wrickert/RickNAS/CAD/CAD Documents/20x20-aluminium-profile-3.snapshot.1/2020 Aluminium profile/Profile dimensions.png

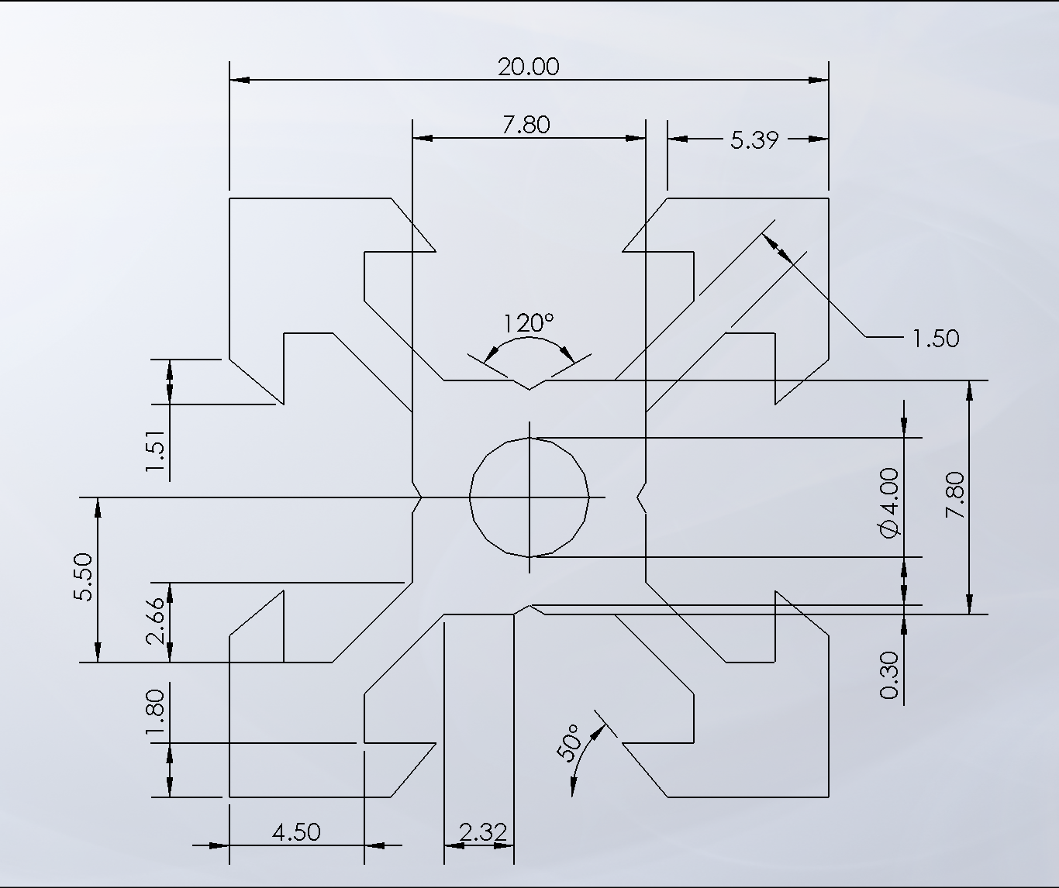
CAD/CAD Documents/20x20-aluminium-profile-3.snapshot.1/2020 Aluminium profile/Profile dimensions.png
