wrickert/RickNAS/CAD/CAD Documents/Front view.png

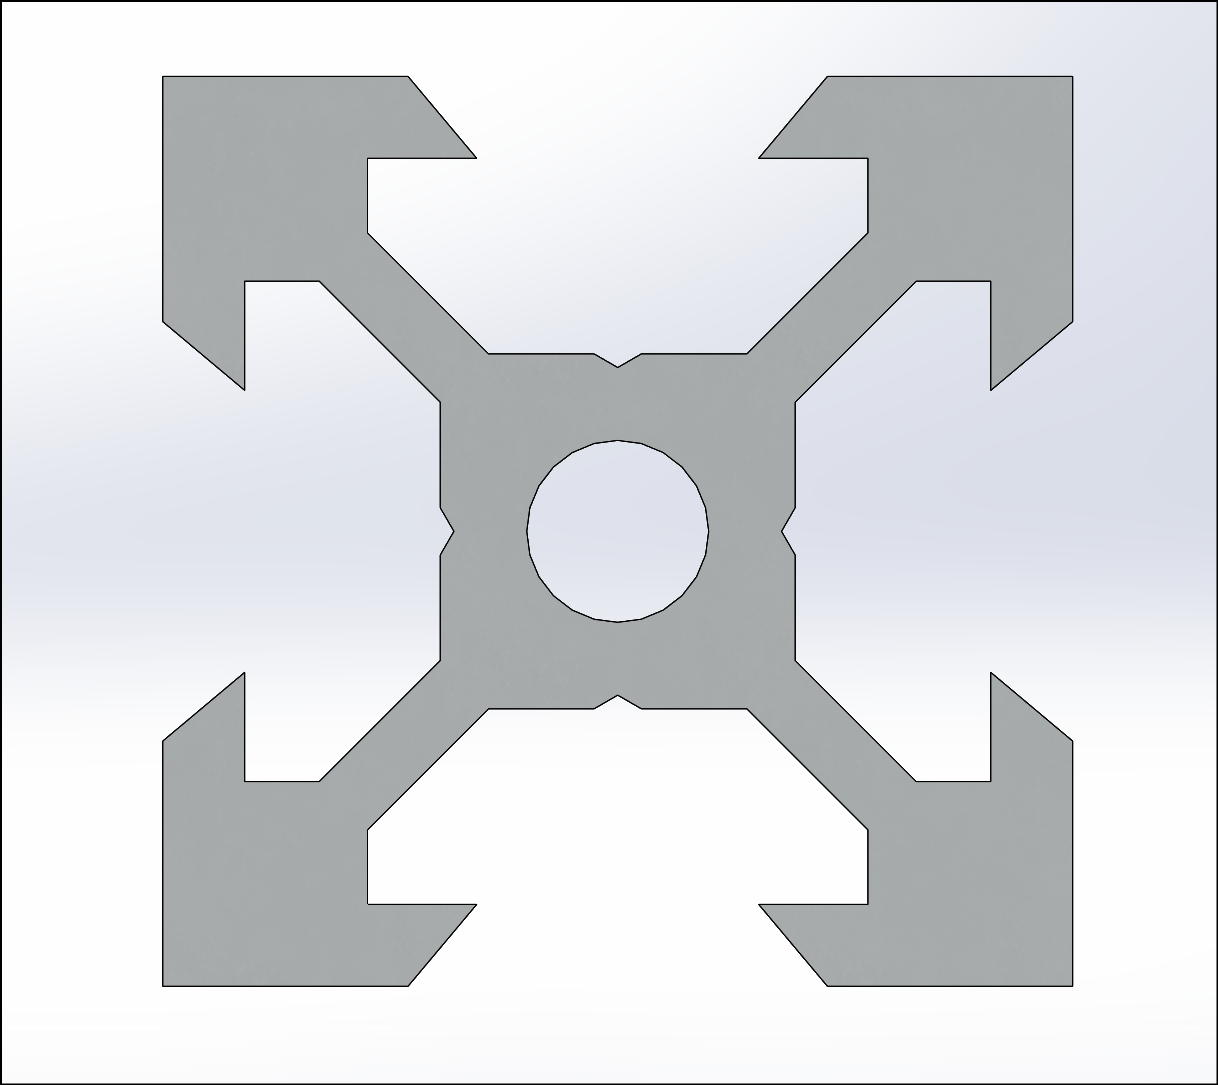
CAD/CAD Documents/Front view.png
