wrickert/RickNAS/Documents/H7c94ff64b4f14f66a1cd68da53533c7fg.jpg

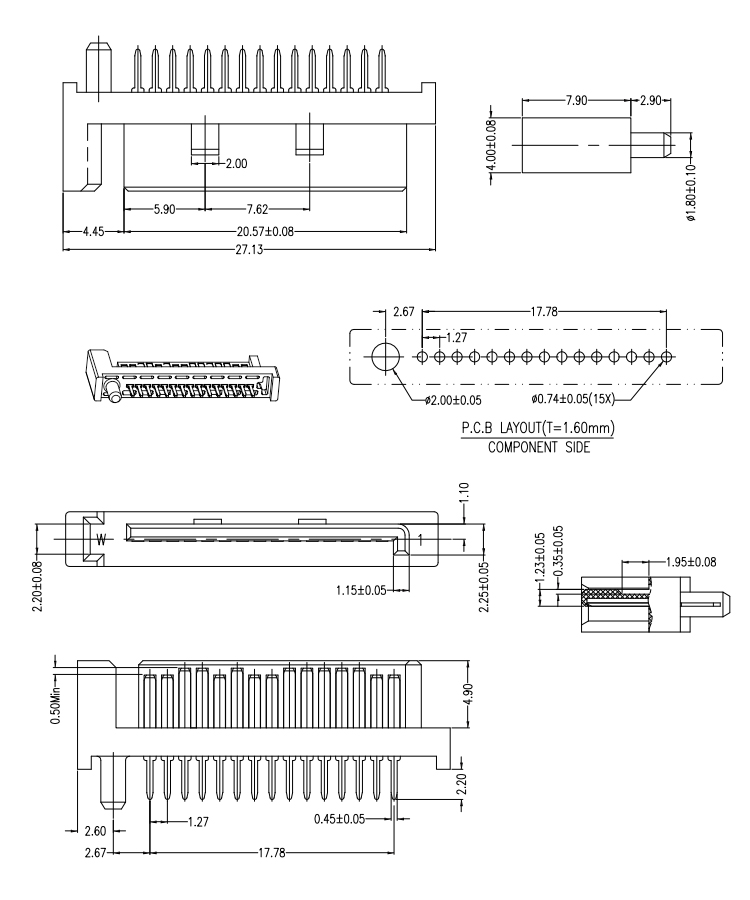
Documents/H7c94ff64b4f14f66a1cd68da53533c7fg.jpg
