wrickert/RickNAS/CAD/CAD Documents/20x20-aluminium-profile-3.snapshot.1/2020 Aluminium profile/ALUMINIUM_PROFILE_20m x 20mm x 500mm.SLDPRT

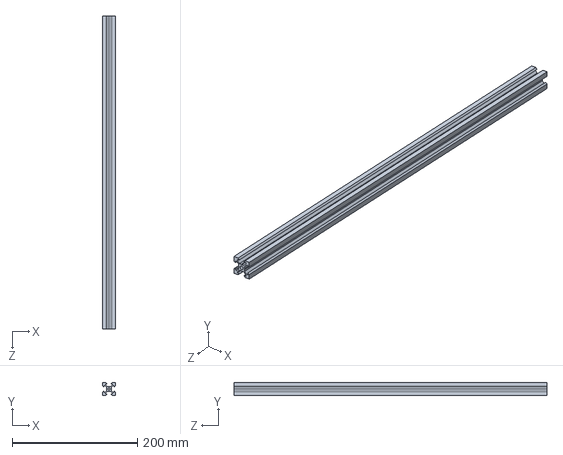
[picture p5: CAD file, 2026-01-15]
CAD/CAD Documents/20x20-aluminium-profile-3.snapshot.1/2020 Aluminium profile/ALUMINIUM_PROFILE_20m x 20mm x 500mm.SLDPRT
20.0 x 20.0 x 500.0 mm
