wrickert/RickNAS/CAD/RickNAS_Case.FCStd

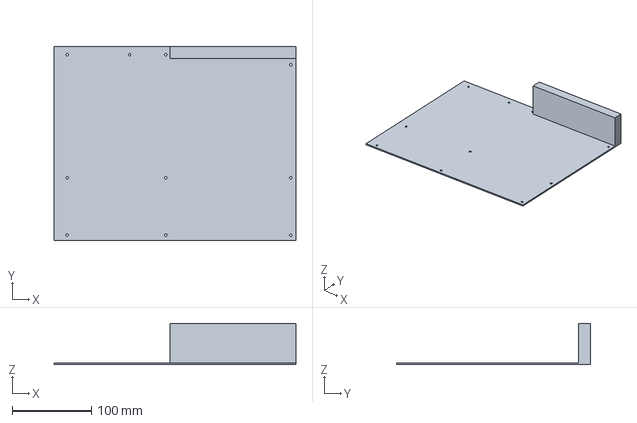
[picture p6: CAD file, 2026-01-15]
CAD/RickNAS_Case.FCStd
305.0 x 244.0 x 51.9 mm
