wrickert/RickNAS/Documents/2227595_1/2227595-1.step

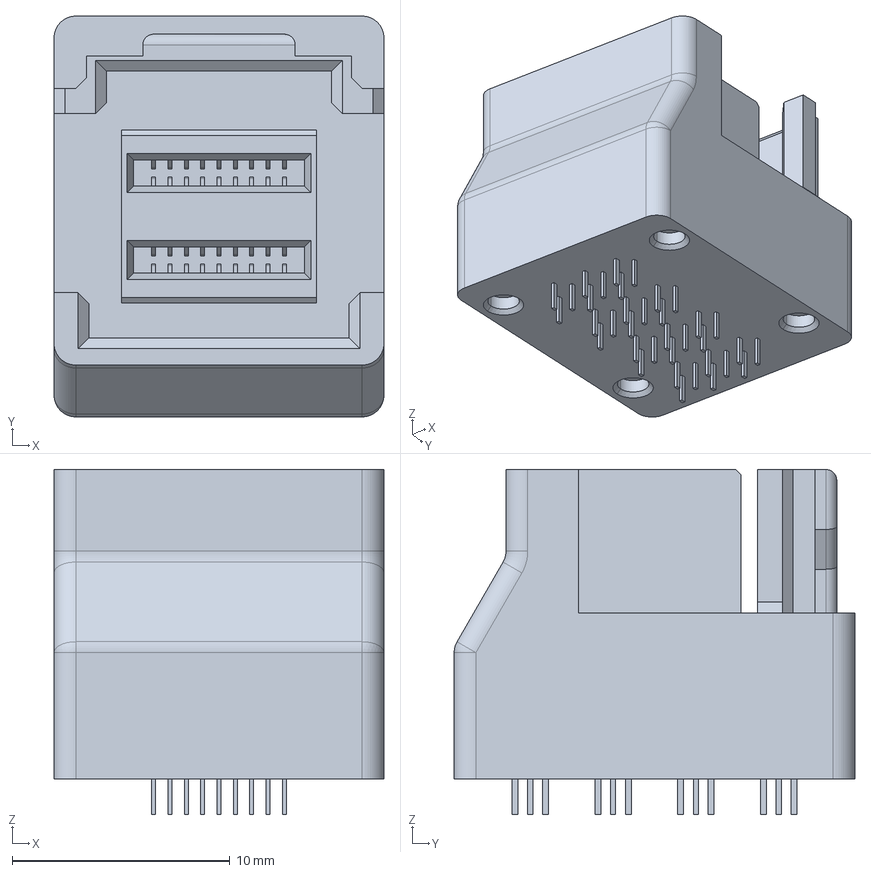
[picture p7: CAD file, 2026-01-15]
Documents/2227595_1/2227595-1.step
15.2 x 18.4 x 15.8 mm
