wrickert/RickNAS/(list of files, cad)

Other CAD files:
Documents/LIB_2227595-1/2227595-1/Allegro/22275951.psm
Documents/LIB_2227595-1/2227595-1/DEHDL/2227595_1/chips/chips.prt
