wrickert/RickNAS/Documents/PK-87839-001-001.pdf

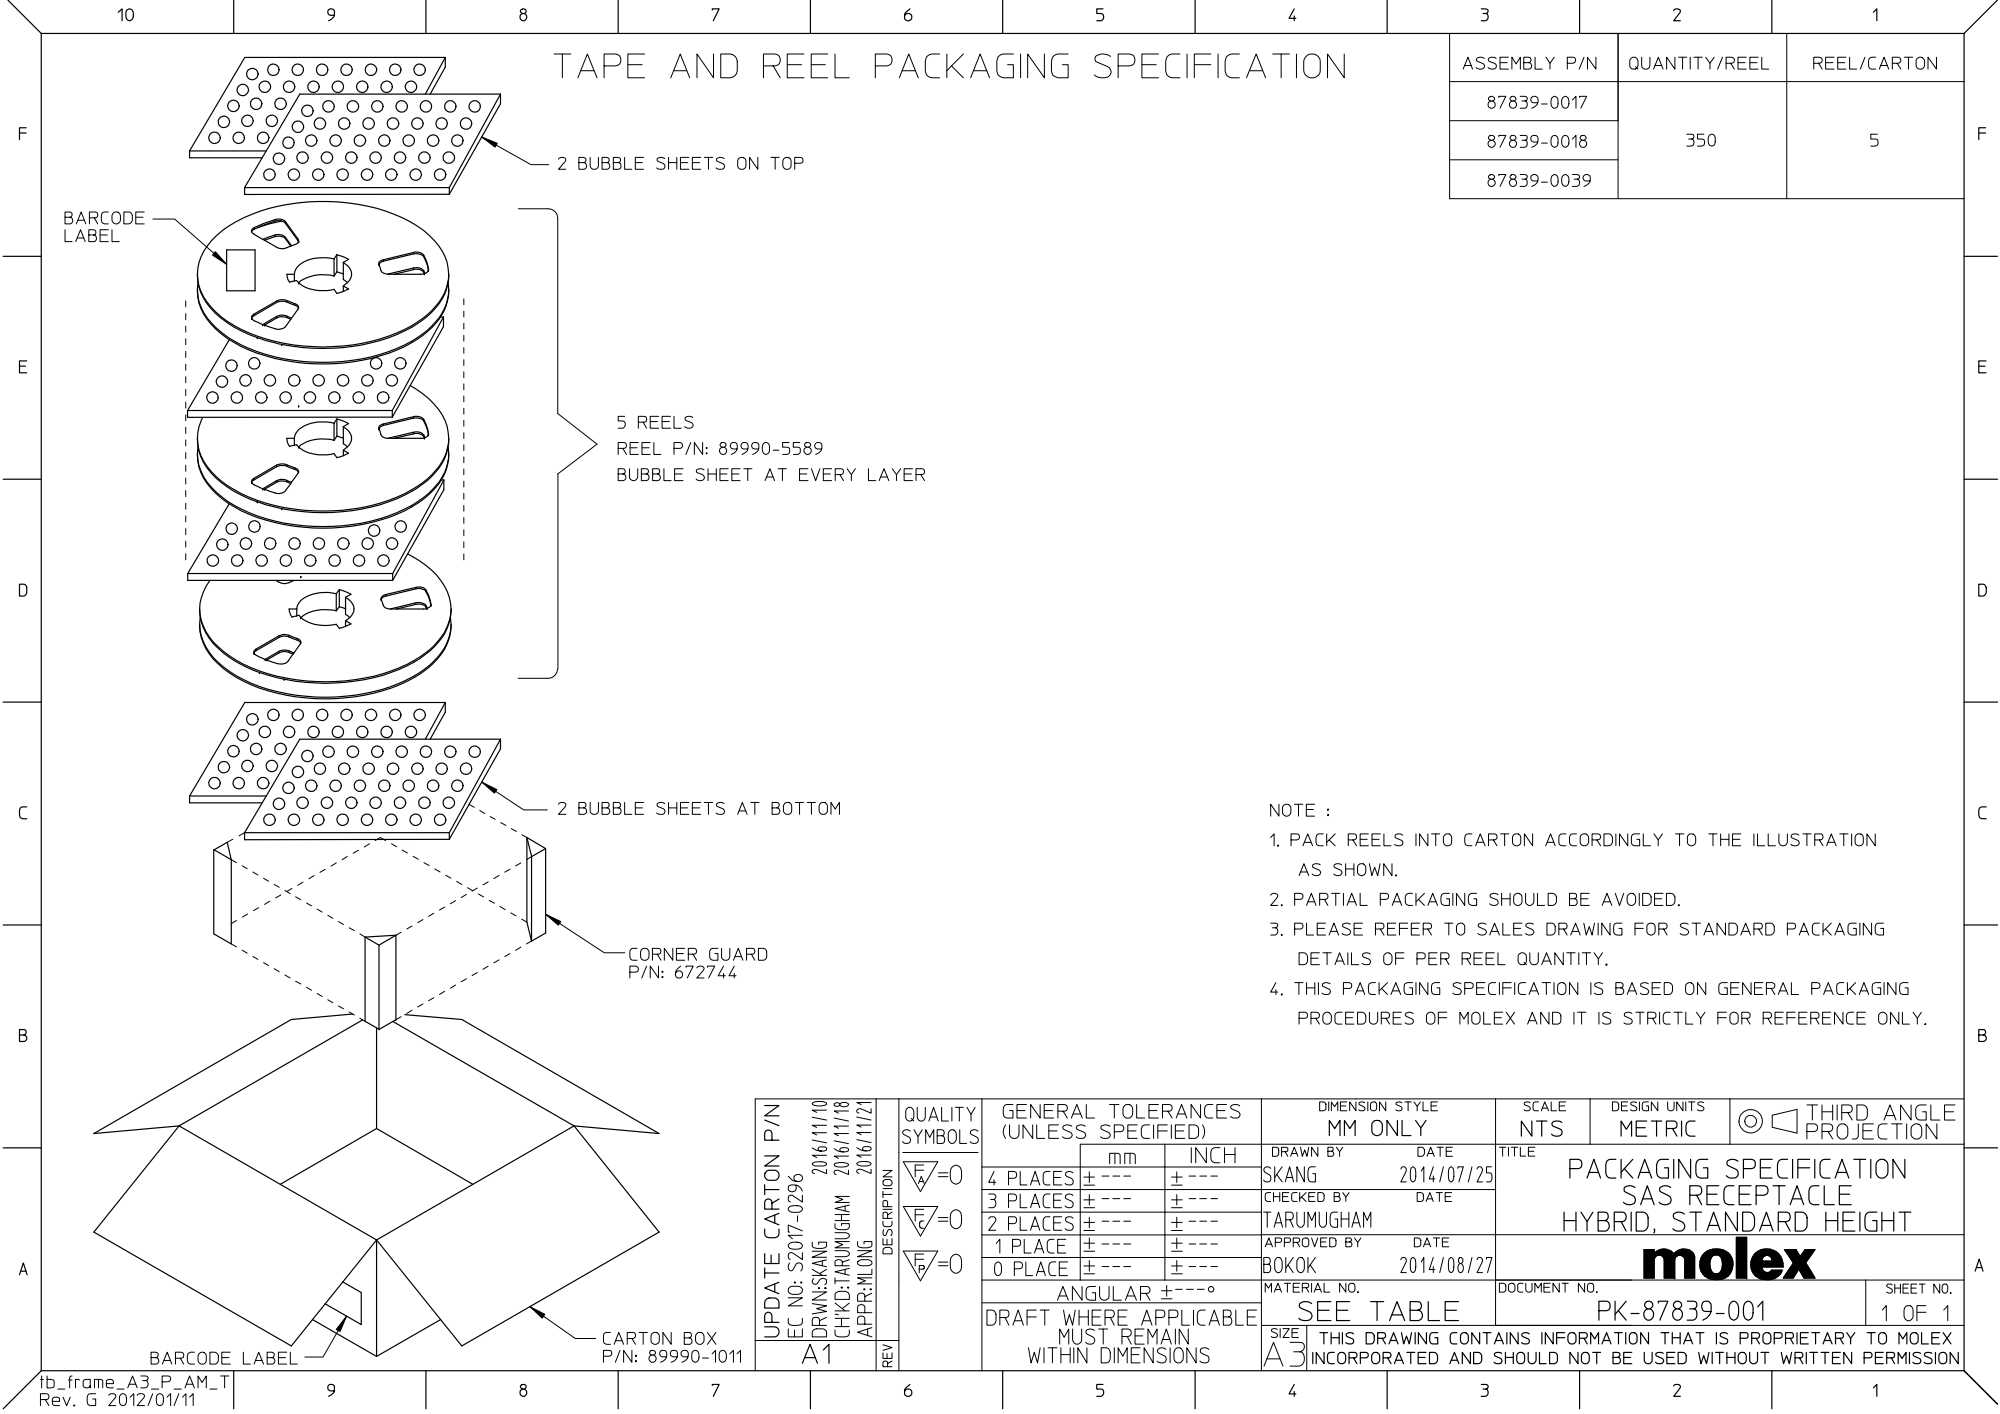
[picture p12: page 1]
