wrickert/RickNAS/(list of files, drawings)

Other design files:
Documents/LIB_2227595-1/2227595-1/Altium/2227595-1.SchLib
Documents/LIB_2227595-1/2227595-1/Altium/22275951.PcbLib
