wrickert/RickNAS/Schematics/V2 - 4 layer PCB/RickNAS_4PortSATA.kicad_pcb

## KiCad design Schematics/V2 - 4 layer PCB/RickNAS_4PortSATA.kicad_pcb (2026-09-16)

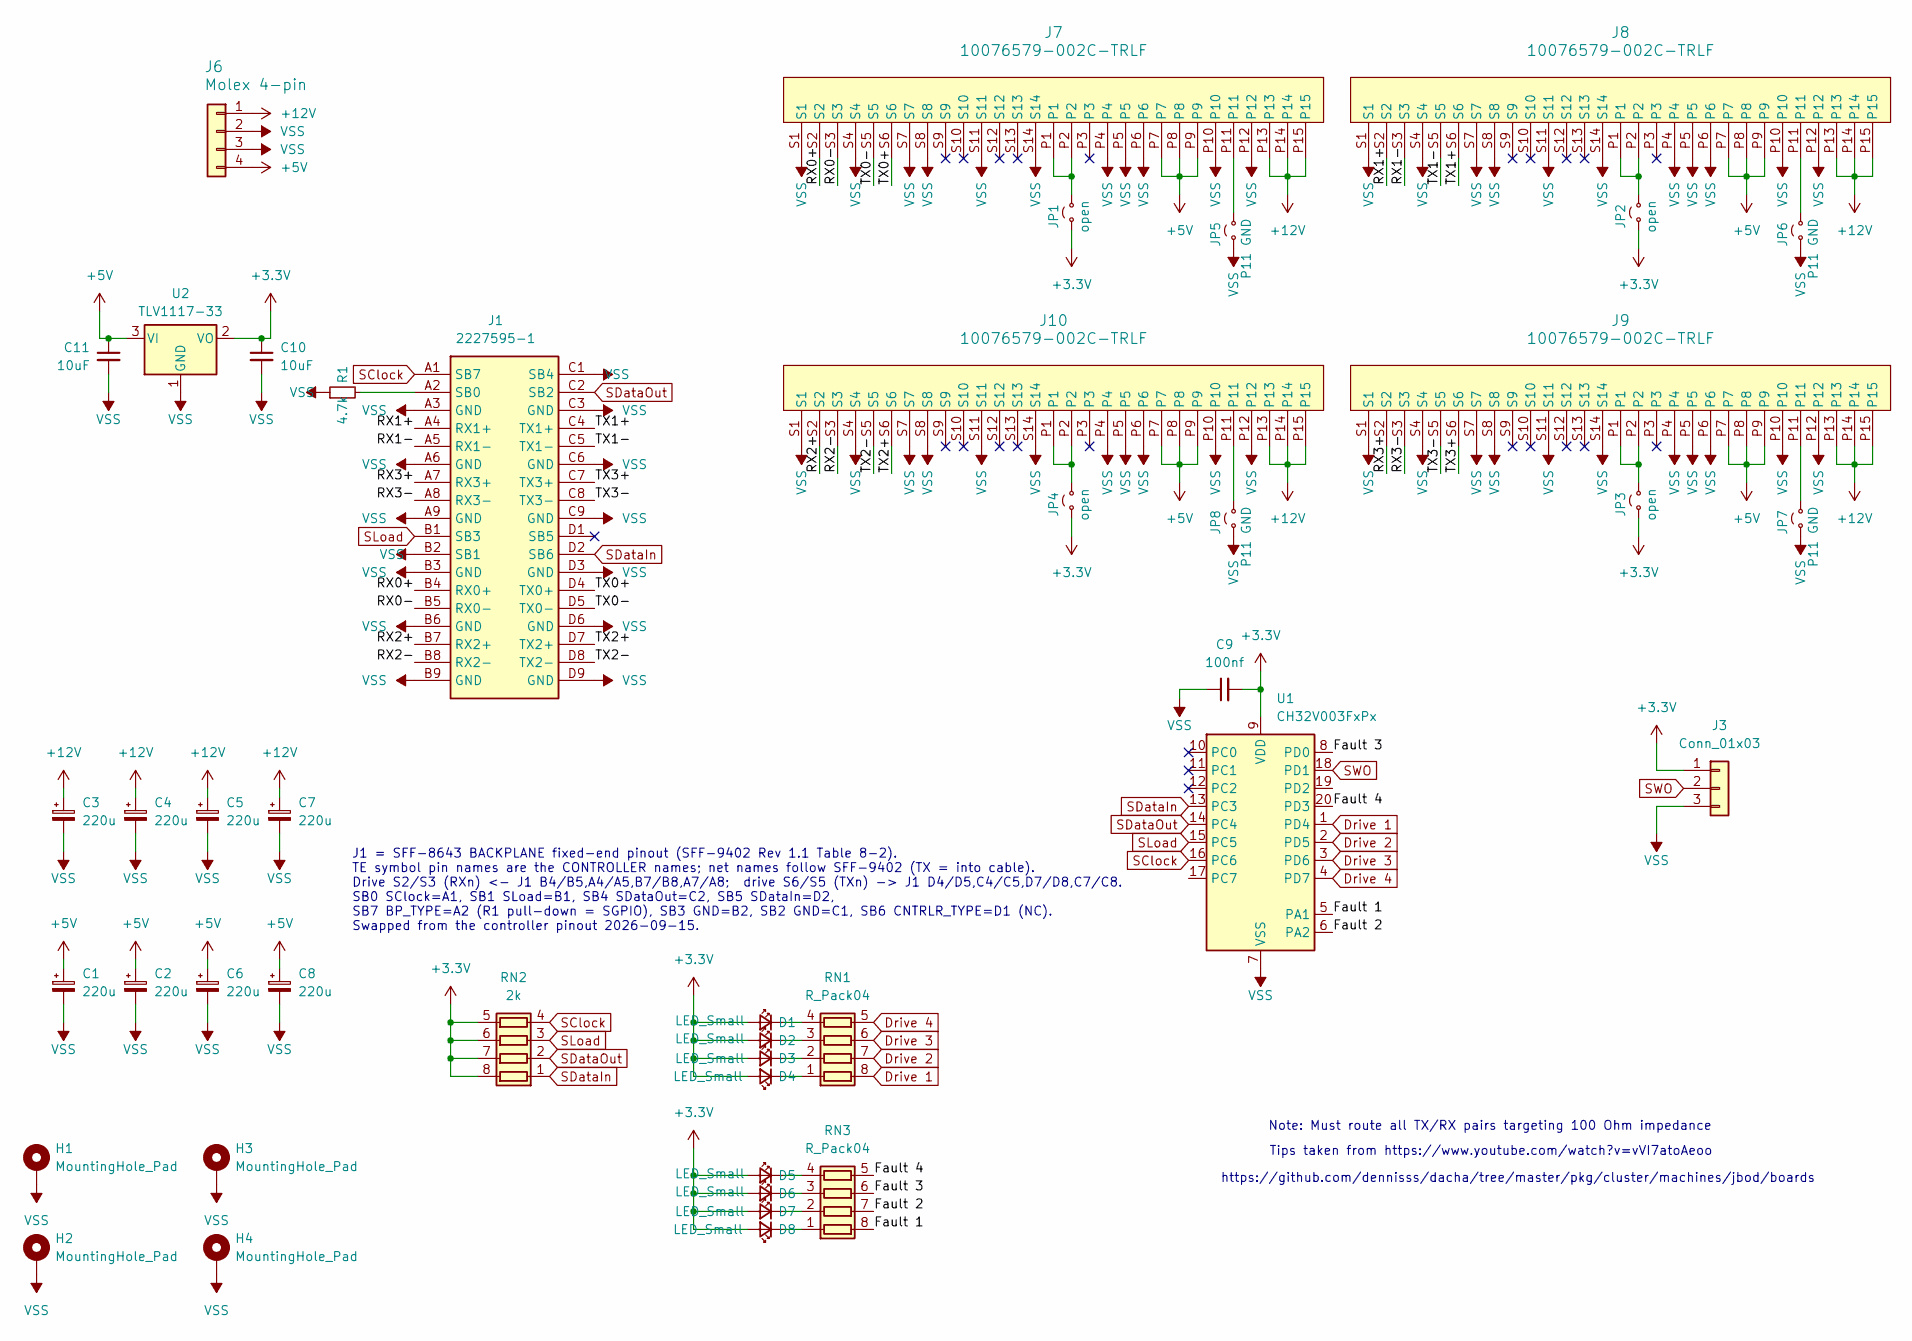
[picture p13: schematic RickNAS_4PortSATA.kicad_sch]

Parts:
C1, C2, C3, C4, C5, C6, C7, C8: 220u; CP_Radial_D10.0mm_P5.00mm
C9: 100nf; C_0805_2012Metric
C10, C11: 10uF; C_0805_2012Metric
D1, D2, D3, D4, D5, D6, D7, D8: LED_Small; LED_0805_2012Metric
H1, H2, H3, H4: MountingHole_Pad; MountingHole_3.2mm_M3_DIN965_Pad
J1: 2227595-1; 22275951; Manufacturer_Part_Number 2227595-1; Mouser Part Number 571-2227595-1
J3: Conn_01x03; PinHeader_1x03_P2.54mm_Vertical
J6: Molex 4-pin; TE_MATE-N-LOK_350211-1_1x04_P5.08mm_Vertical; MPN HC-C5080-4AS; LCSC C5221226
J7, J8, J9, J10: 10076579-002C-TRLF; 91908-291512_SAS_Conn
JP1, JP2, JP3, JP4: open; SolderJumper-2_P1.3mm_Open_TrianglePad1.0x1.5mm
JP5, JP6, JP7, JP8: P11 GND; SolderJumper-2_P1.3mm_Open_TrianglePad1.0x1.5mm
R1: 4.7k; R_0603_1608Metric
RN1, RN3: R_Pack04; R_Array_Concave_4x0603
RN2: 2k; R_Array_Concave_4x0603
U1: CH32V003FxPx; TSSOP-20_4.4x6.5mm_P0.65mm
U2: TLV1117-33; SOT-223-3_TabPin2

Connections:
+3.3V: C9.2, C10.1, D1.2 (A), D2.2 (A), D3.2 (A), D4.2 (A), D5.2 (A), D6.2 (A), D7.2 (A), D8.2 (A), J3.1, JP1.1 (A), JP2.1 (A), JP3.1 (A), JP4.1 (A), RN2.5 (R4.2), RN2.6 (R3.2), RN2.7 (R2.2), RN2.8 (R1.2), U1.9 (VDD), U2.2 (VO)
+5V: C1.1, C2.1, C6.1, C8.1, C11.1, J6.4, J7.P7, J7.P8, J7.P9, J8.P7, J8.P8, J8.P9, J9.P7, J9.P8, J9.P9, J10.P7, J10.P8, J10.P9, U2.3 (VI)
+12V: C3.1, C4.1, C5.1, C7.1, J6.1, J7.P13, J7.P14, J7.P15, J8.P13, J8.P14, J8.P15, J9.P13, J9.P14, J9.P15, J10.P13, J10.P14, J10.P15
/Fault 1: RN3.8 (R1.2), U1.5 (PA1)
/Fault 2: RN3.7 (R2.2), U1.6 (PA2)
/Fault 3: RN3.6 (R3.2), U1.8 (PD0)
/Fault 4: RN3.5 (R4.2), U1.20 (PD3)
/RX0+: J1.B4 (RX0+), J7.S2
/RX0-: J1.B5 (RX0-), J7.S3
/RX1+: J1.A4 (RX1+), J8.S2
/RX1-: J1.A5 (RX1-), J8.S3
/RX2+: J1.B7 (RX2+), J10.S2
/RX2-: J1.B8 (RX2-), J10.S3
/RX3+: J1.A7 (RX3+), J9.S2
/RX3-: J1.A8 (RX3-), J9.S3
/TX0+: J1.D4 (TX0+), J7.S6
/TX0-: J1.D5 (TX0-), J7.S5
/TX1+: J1.C4 (TX1+), J8.S6
/TX1-: J1.C5 (TX1-), J8.S5
/TX2+: J1.D7 (TX2+), J10.S6
/TX2-: J1.D8 (TX2-), J10.S5
/TX3+: J1.C7 (TX3+), J9.S6
/TX3-: J1.C8 (TX3-), J9.S5
Drive 1: RN1.8 (R1.2), U1.1 (PD4)
Drive 2: RN1.7 (R2.2), U1.2 (PD5)
Drive 3: RN1.6 (R3.2), U1.3 (PD6)
Drive 4: RN1.5 (R4.2), U1.4 (PD7)
unnamed: D1.1 (K), RN1.4 (R4.1)
unnamed: D2.1 (K), RN1.3 (R3.1)
unnamed: D3.1 (K), RN1.2 (R2.1)
unnamed: D4.1 (K), RN1.1 (R1.1)
unnamed: D5.1 (K), RN3.4 (R4.1)
unnamed: D6.1 (K), RN3.3 (R3.1)
unnamed: D7.1 (K), RN3.2 (R2.1)
unnamed: D8.1 (K), RN3.1 (R1.1)
unnamed: J1.A2 (SB0), R1.2
unnamed: J7.P1, J7.P2, JP1.2 (B)
unnamed: J8.P1, J8.P2, JP2.2 (B)
unnamed: J9.P1, J9.P2, JP3.2 (B)
unnamed: J10.P1, J10.P2, JP4.2 (B)
unnamed: J7.P11, JP5.2 (B)
unnamed: J8.P11, JP6.2 (B)
unnamed: J9.P11, JP7.2 (B)
unnamed: J10.P11, JP8.2 (B)
SClock: J1.A1 (SB7), RN2.4 (R4.1), U1.16 (PC6)
SDataIn: J1.D2 (SB6), RN2.1 (R1.1), U1.13 (PC3)
SDataOut: J1.C2 (SB2), RN2.2 (R2.1), U1.14 (PC4)
SLoad: J1.B1 (SB3), RN2.3 (R3.1), U1.15 (PC5)
SWO: J3.2, U1.18 (PD1)
VSS: C1.2, C2.2, C3.2, C4.2, C5.2, C6.2, C7.2, C8.2, C9.1, C10.2, C11.2, H1.1 (1_1), H2.1 (1_1), H3.1 (1_1), H4.1 (1_1), J1.A3 (GND), J1.A6 (GND), J1.A9 (GND), J1.B2 (SB1), J1.B3 (GND), J1.B6 (GND), J1.B9 (GND), J1.C1 (SB4), J1.C3 (GND), J1.C6 (GND), J1.C9 (GND), J1.D3 (GND), J1.D6 (GND), J1.D9 (GND), J3.3, J6.2, J6.3, J7.P4, J7.P5, J7.P6, J7.P10, J7.P12, J7.S1, J7.S4, J7.S7, J7.S8, J7.S11, J7.S14, J8.P4, J8.P5, J8.P6, J8.P10, J8.P12, J8.S1, J8.S4, J8.S7, J8.S8, J8.S11, J8.S14, J9.P4, J9.P5, J9.P6, J9.P10, J9.P12, J9.S1, J9.S4, J9.S7, J9.S8, J9.S11, J9.S14, J10.P4, J10.P5, J10.P6, J10.P10, J10.P12, J10.S1, J10.S4, J10.S7, J10.S8, J10.S11, J10.S14, JP5.1 (A), JP6.1 (A), JP7.1 (A), JP8.1 (A), R1.1, U1.7 (VSS), U2.1 (GND)

Notes on the sheet:
https://github.com/dennisss/dacha/tree/master/pkg/cluster/machines/jbod/boards
Tips taken from https://www.youtube.com/watch?v=vVI7atoAeoo
Note: Must route all TX/RX pairs targeting 100 Ohm impedance
J1 = SFF-8643 BACKPLANE fixed-end pinout (SFF-9402 Rev 1.1 Table 8-2). TE symbol pin names are the CONTROLLER names; net names follow SFF-9402 (TX = into cable). Drive S2/S3 (RXn) <- J1 B4/B5,A4/A5,B7/B8,A7/A8; drive S6/S5 (TXn) -> J1 D4/D5,C4/C5,D7/D8,C7/C8. SB0 SClock=A1, SB1 SLoad=B1, SB4 SDataO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

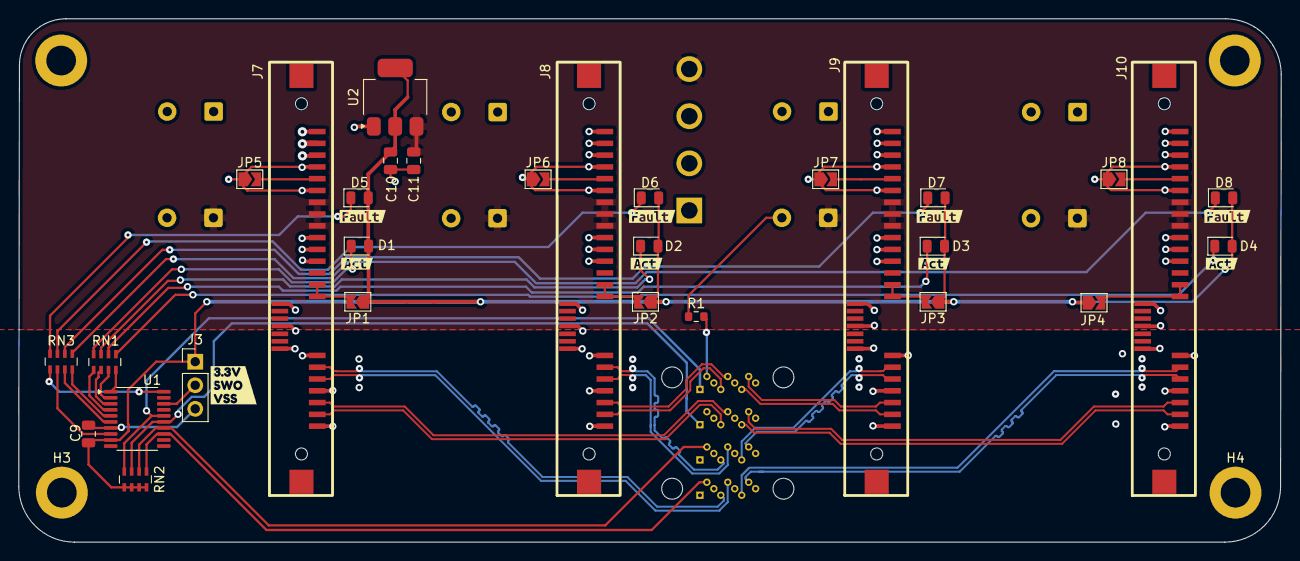
[picture p14: board Schematics/V2 - 4 layer PCB/RickNAS_4PortSATA.kicad_pcb from above]

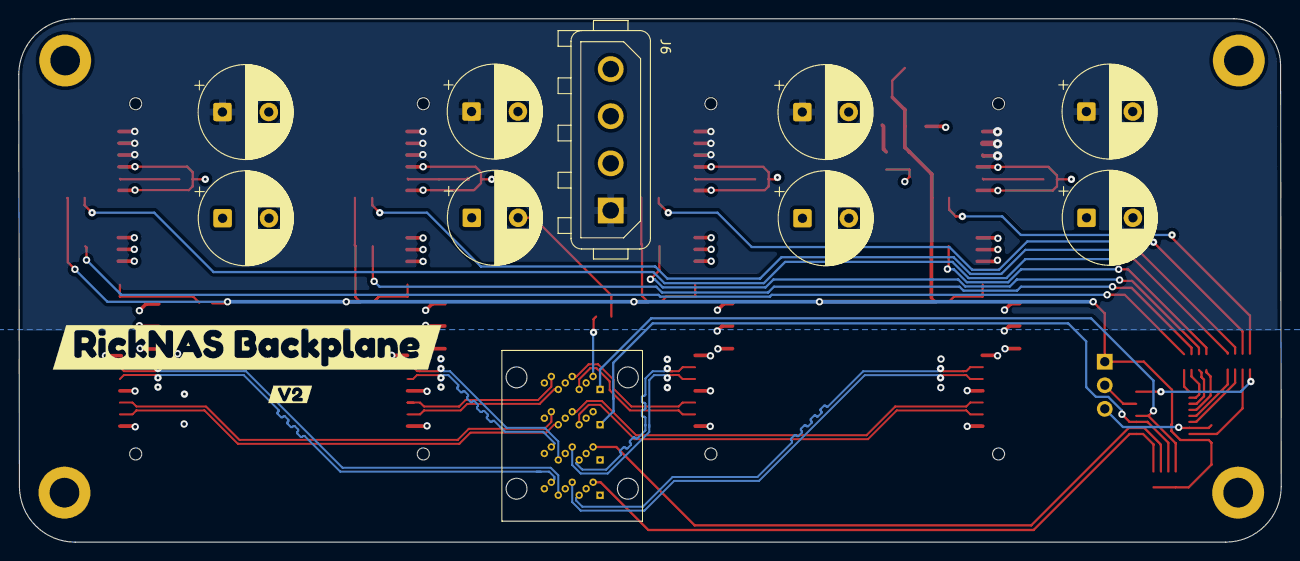
[picture p15: board Schematics/V2 - 4 layer PCB/RickNAS_4PortSATA.kicad_pcb from below]

Board: 4 copper layers, 136.1 x 56.4 mm, 55 parts (12 on the bottom side), 50 nets.

Other parts of the board:
kibuzzard-6AAAB40B: G***; kibuzzard-6AAAB40B
kibuzzard-6AAAB169, kibuzzard-6AAAB169#2, kibuzzard-6AAAB169#3, kibuzzard-6AAAB169#4: G***; kibuzzard-6AAAB169
kibuzzard-6AAAB175, kibuzzard-6AAAB175#2, kibuzzard-6AAAB175#3, kibuzzard-6AAAB175#4: G***; kibuzzard-6AAAB175
kibuzzard-6AAAC547: G***; kibuzzard-6AAAC547
kibuzzard-69861090: G***; kibuzzard-69861090
