wrickert/RickNAS/Schematics/V1 - 2 layer PCB/RickNAS_4PortSATA.kicad_pcb

## KiCad design Schematics/V1 - 2 layer PCB/RickNAS_4PortSATA.kicad_pcb (2025-03-04)

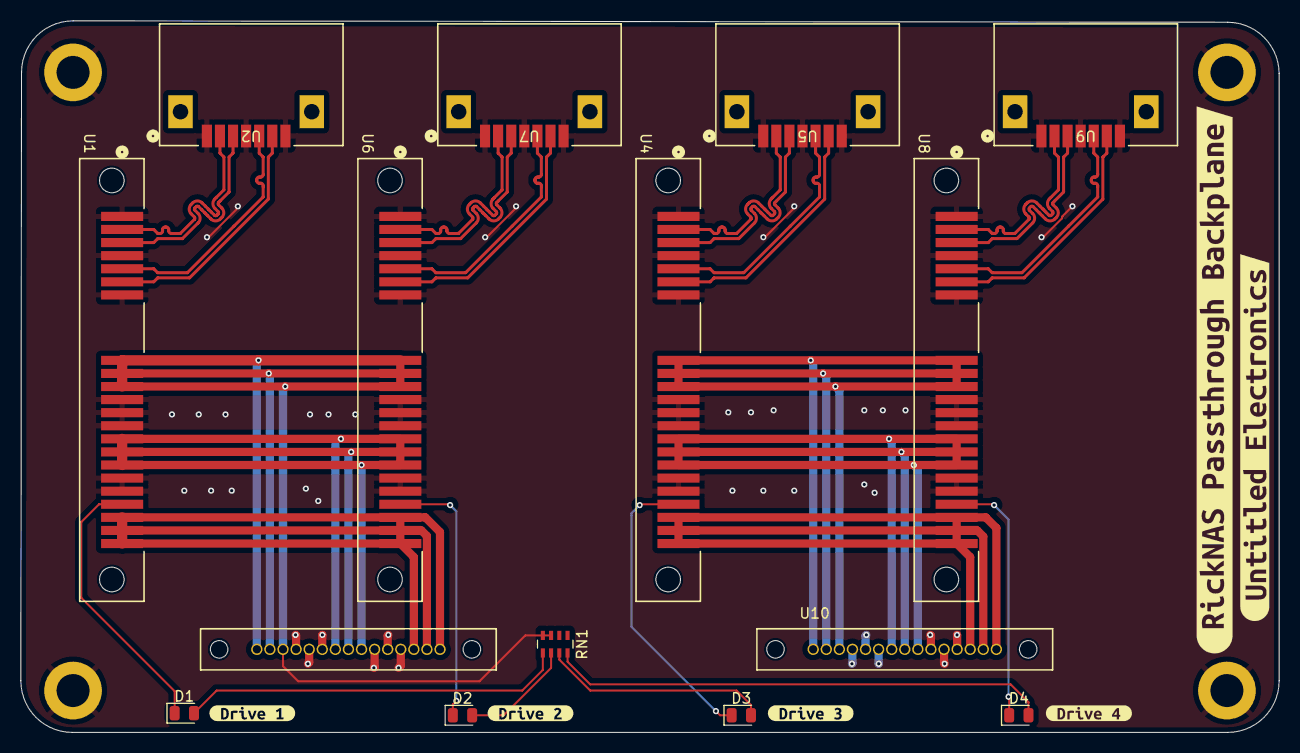
[picture p16: board Schematics/V1 - 2 layer PCB/RickNAS_4PortSATA.kicad_pcb from above]

Board: 2 copper layers, 122.1 x 69.1 mm, 25 parts (0 on the bottom side), 31 nets.

Parts:
D1, D2, D3, D4: LED_Small; LED_0805_2012Metric
H1, H2, H3, H4: MountingHole_Pad; MountingHole_3.2mm_M3_DIN965_Pad
RN1: R_Pack04; R_Array_Concave_4x0603
U1, U4, U6, U8: SATA_Combined; CONN22_877811_MOL
U2, U5, U7, U9: SATA_Data; CONN_67490-1220_MOL
U3, U10: SATA_Power; alim_SATA
kibuzzard-67B4AC4E: G***; kibuzzard-67B4AC4E
kibuzzard-67B605A5: G***; kibuzzard-67B605A5
kibuzzard-67B605B2: G***; kibuzzard-67B605B2
kibuzzard-67B6042A: G***; kibuzzard-67B6042A
kibuzzard-67B60589: G***; kibuzzard-67B60589
kibuzzard-67B60597: G***; kibuzzard-67B60597

Connections:
+3.3V: RN1.1 (R1.1), RN1.2 (R2.1), RN1.3 (R3.1), RN1.4 (R4.1), U1.8 (3.3V), U1.9 (3.3V), U1.10 (3.3V), U3.1 (3.3V), U3.2 (3.3V), U3.3 (3.3V), U6.8 (3.3V), U6.9 (3.3V), U6.10 (3.3V)
+3.3VP: U4.8 (3.3V), U4.9 (3.3V), U4.10 (3.3V), U8.8 (3.3V), U8.9 (3.3V), U8.10 (3.3V), U10.1 (3.3V), U10.2 (3.3V), U10.3 (3.3V)
+5P: U4.14 (5V), U4.15 (5V), U4.16 (5V), U8.14 (5V), U8.15 (5V), U8.16 (5V), U10.7 (5V), U10.8 (5V), U10.9 (5V)
+5V: U1.14 (5V), U1.15 (5V), U1.16 (5V), U3.7 (5V), U3.8 (5V), U3.9 (5V), U6.14 (5V), U6.15 (5V), U6.16 (5V)
+12P: U4.20 (12V), U4.21 (12V), U4.22 (12V), U8.20 (12V), U8.21 (12V), U8.22 (12V), U10.13 (12V), U10.14 (12V), U10.15 (12V)
+12V: U1.20 (12V), U1.21 (12V), U1.22 (12V), U3.13 (12V), U3.14 (12V), U3.15 (12V), U6.20 (12V), U6.21 (12V), U6.22 (12V)
/A1+: U4.2 (A+), U5.2 (A+)
/A1-: U4.3 (A-), U5.3 (A-)
/A2+: U6.2 (A+), U7.2 (A+)
/A2-: U6.3 (A-), U7.3 (A-)
/A3+: U8.2 (A+), U9.2 (A+)
/A3-: U8.3 (A-), U9.3 (A-)
/A+: U1.2 (A+), U2.2 (A+)
/A-: U1.3 (A-), U2.3 (A-)
/B1+: U4.6 (B+), U5.6 (B+)
/B1-: U4.5 (B-), U5.5 (B-)
/B2+: U6.6 (B+), U7.6 (B+)
/B2-: U6.5 (B-), U7.5 (B-)
/B3+: U8.6 (B+), U9.6 (B+)
/B3-: U8.5 (B-), U9.5 (B-)
/B+: U1.6 (B+), U2.6 (B+)
/B-: U1.5 (B-), U2.5 (B-)
Drive 1: D1.1 (K), U1.19 (VSS)
Drive 2: D2.1 (K), U6.19 (VSS)
Drive 3: D3.1 (K), U4.19 (VSS)
Drive 4: D4.1 (K), U8.19 (VSS)
unnamed: D1.2 (A), RN1.5 (R4.2)
unnamed: D2.2 (A), RN1.6 (R3.2)
unnamed: D3.2 (A), RN1.7 (R2.2)
unnamed: D4.2 (A), RN1.8 (R1.2)
VSS: H1.1, H2.1, H3.1, H4.1, U1.1 (VSS), U1.4 (VSS), U1.7 (VSS), U1.11 (VSS), U1.12 (VSS), U1.13 (VSS), U1.17 (VSS), U1.18 (VSS), U2.1 (VSS), U2.4 (VSS), U2.7 (VSS), U3.4 (VSS), U3.5 (VSS), U3.6 (VSS), U3.10 (VSS), U3.11 (VSS), U3.12 (VSS), U4.1 (VSS), U4.4 (VSS), U4.7 (VSS), U4.11 (VSS), U4.12 (VSS), U4.13 (VSS), U4.17 (VSS), U4.18 (VSS), U5.1 (VSS), U5.4 (VSS), U5.7 (VSS), U6.1 (VSS), U6.4 (VSS), U6.7 (VSS), U6.11 (VSS), U6.12 (VSS), U6.13 (VSS), U6.17 (VSS), U6.18 (VSS), U7.1 (VSS), U7.4 (VSS), U7.7 (VSS), U8.1 (VSS), U8.4 (VSS), U8.7 (VSS), U8.11 (VSS), U8.12 (VSS), U8.13 (VSS), U8.17 (VSS), U8.18 (VSS), U9.1 (VSS), U9.4 (VSS), U9.7 (VSS), U10.4 (VSS), U10.5 (VSS), U10.6 (VSS), U10.10 (VSS), U10.11 (VSS), U10.12 (VSS)
