wrickert/RickNAS/(commit log)

2025-02-07 Schematic done
    [RickNAS_4PortSATA.kicad_pcb, RickNAS_4PortSATA.kicad_sch]
2025-02-10 Assigned some footprints. Where is that sata power part?
    [RickNAS_4PortSATA.kicad_sch]
2025-02-18 Ordering PCBs
    [RickNAS_4PortSATA-B_Cu.gbr, RickNAS_4PortSATA-B_Mask.gbr, RickNAS_4PortSATA-B_Paste.gbr, RickNAS_4PortSATA-B_Silkscreen.gbr, RickNAS_4PortSATA-Edge_Cuts.gbr, RickNAS_4PortSATA-F_Cu.gbr, RickNAS_4PortSATA-F_Mask.gbr, RickNAS_4PortSATA-F_Paste.gbr]
2025-03-04 Started CAD
    [RickNAS_4PortSATA-B_Cu.gbr, RickNAS_4PortSATA-B_Mask.gbr, RickNAS_4PortSATA-B_Paste.gbr, RickNAS_4PortSATA-B_Silkscreen.gbr, RickNAS_4PortSATA-Edge_Cuts.gbr, RickNAS_4PortSATA-F_Cu.gbr, RickNAS_4PortSATA-F_Mask.gbr, RickNAS_4PortSATA-F_Paste.gbr]
2026-01-15 Progress on V2
    [2227595-1.SchLib, 2227595-1.step, 2227595-1.stp, 22275951.PcbLib, 22275951.psm, ALUMINIUM_PROFILE_20m x 20mm x 500mm.SLDPRT, EDI2CAP.CFG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]
2026-01-16 Progress on routing
    [RickNAS_4PortSATA.kicad_pcb]
2026-02-06 V2 finished, ordering PCB
    [RickNAS_4PortSATA-B_Cu.gbr, RickNAS_4PortSATA-B_Mask.gbr, RickNAS_4PortSATA-B_Paste.gbr, RickNAS_4PortSATA-B_Silkscreen.gbr, RickNAS_4PortSATA-Edge_Cuts.gbr, RickNAS_4PortSATA-F_Cu.gbr, RickNAS_4PortSATA-F_Mask.gbr, RickNAS_4PortSATA-F_Paste.gbr]
2026-04-10 Lets build some boards
2026-09-14 ran erc
    [RickNAS_4PortSATA-B_Cu.gbr, RickNAS_4PortSATA-B_Mask.gbr, RickNAS_4PortSATA-B_Paste.gbr, RickNAS_4PortSATA-B_Silkscreen.gbr, RickNAS_4PortSATA-Edge_Cuts.gbr, RickNAS_4PortSATA-F_Cu.gbr, RickNAS_4PortSATA-F_Mask.gbr, RickNAS_4PortSATA-F_Paste.gbr]
2026-09-15 Rewire J1 to SFF-8643 backplane fixed-end pinout
    V1 failed because J1 used the controller pinout on a backplane; SAS
    cables are full crossover (SFF-9402 Rev 1.1 Table 8-2).
    - J7-J10: drive S2/S3 now on RXn (J1 B/A rows), S6/S5 on TXn (J1 D/C rows)
    - J1 sideband: SClock A1, SLoad B1, SDataOut C2, SDataIn D2
    - A2 (BP_TYPE) pulled down via R1 4.7k = SGPIO; B2/C1 to VSS; D1 NC
    - Note on sheet explaining the pinout
    PCB not yet updated from schematic; pairs need rerouting.
    [RickNAS_4PortSATA.kicad_sch]
2026-09-15 Fixed traces
    [RickNAS_4PortSATA.kicad_pcb, RickNAS_4PortSATA.kicad_sch]
2026-09-15 Set board stackup to JLC04161H-7628
    Prepreg 7628 0.2104 mm Er 4.4, core 1.065 mm Er 4.6, inner Cu 0.5 oz,
    mask 0.03 mm Er 3.8. SATA netclass 0.2182/0.2 mm is ~100 ohm on this
    stackup; order with Nan Ya NP-155F material.
    [RickNAS_4PortSATA.kicad_pcb]
2026-09-15 Re-added traces
    [RickNAS_4PortSATA.kicad_pcb, RickNAS_4PortSATA.kicad_sch]
2026-09-15 Improved traces and cleaned silkscreen
    [RickNAS_4PortSATA.kicad_pcb]
2026-09-15 Tune TX pair skew with bumps on B.Cu
    KiCad-measured intra-pair skew before -> after:
    TX0 1.9555 -> <0.001 mm (4 bumps on TX0+)
    TX1 2.1315 -> 0.0025 mm (2+2 bumps on TX1+)
    TX2 1.4995 -> <0.001 mm (3 bumps on TX2-)
    TX3 1.9555 -> <0.001 mm (4 bumps on TX3-)
    Bumps: 45-degree chamfers (0.1 mm), height 0.36-0.38 mm (<2x pair gap),
    top/spacing 0.55 mm, outward from partner. DRC unchanged (29 known),
    0 unconnected, nothing new within 0.6 mm of the pairs.
    [RickNAS_4PortSATA.kicad_pcb]
2026-09-16 Small schematic change
    [RickNAS_4PortSATA.kicad_sch]
2026-09-16 Molex power input, P11 GND jumpers, split P3, drop J2
    - J6: 2x2 Micro-Fit -> 4-pin PC peripheral power header (TE MATE-N-LOK
    350211-1 footprint; MPN HC-C5080-4AS / LCSC C5221226). Pins 1=+12V,
    2=GND, 3=GND, 4=+5V. Micro-Fit's 5 A contact was below 4-drive spin-up.
    - P11 on J7-J10 through open solder jumpers JP5-JP8 to VSS (default
    floating = staggered spin-up; bridge for immediate spin-up).
    - P3 (PWDIS) split off the P1/P2 3.3V bracket on all drives, now NC, so
    closing JP1-JP4 no longer holds drives in power-disable.
    - J2 removed; U1 PC0-PC2 marked no-connect.
    - RN2 (SGPIO 2k pull-ups, SFF-8485 6.2): value 2k, footprint
    R_Array_Concave_4x0603 (was 4-pad SIP4 on an 8-pin symbol).
    P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
    [RickNAS_4PortSATA.kicad_sch]
2026-09-16 Add per-bay fault/locate LEDs on spare CH32V003 pins
    D5-D8 (red 0805) + RN3 1k array, wired like the activity LEDs D1-D4
    (anode +3.3V, sunk through the array by U1). Global labels Fault 1-4:
    Fault 1 -> PC0 (pin 10), Fault 2 -> PC7 (17),
    Fault 3 -> PD0 (8), Fault 4 -> PA1 (5)
    Leaves PC1/PC2 (I2C) and PD2/PD3/PA2 (ADC) free. Each bay's fault LED
    shares a row with its activity LED (Drive n / Fault n on the same
    RN pair position). Firmware: SGPIO locate/fault bits drive these.
    [RickNAS_4PortSATA.kicad_sch]
2026-09-16 Revert "Add per-bay fault/locate LEDs on spare CH32V003 pins"
    This reverts commit eeb4463. William is adding the fault LEDs himself.
    [RickNAS_4PortSATA.kicad_sch]
2026-09-16 Pemultimate v2 pcb commit
    [RickNAS_4PortSATA.kicad_pcb, RickNAS_4PortSATA.kicad_sch]
2026-09-16 Ignore KiCad backups and lock files; stop tracking existing ones
    Files remain on disk; only removed from the index.
2026-09-16 Further cleanup
    [RickNAS_4PortSATA.kicad_pcb]
